nlbutts/coilgun/docs/design comparison.xlsx

Sheet: External Iron Testing
Washers | no washers | Ext Iron | Ext Iron2
10.29365509 | 10.65443507 | 10.03970386 | 10.06696618
18.79807226 | 16.36530327 | 19.62548278 | 19.64912549
20.94035492 | 18.17367863 | 22.6647233 | 22.24324136
21.30288856 | 19.68596519 | 22.79737086 | 22.96717005
20.60404159 | 18.18767754 | 22.31704167 | 21.54015561
18.5911185 | 15.64249792 | 19.94597873 | 19.95455111
13.24380927 | 10.58423559 | 13.75355467 | 13.80529892
2.974283821 | 4.068087345 | 3.183165582 | 3.27684716
-0.009587470903 | 0.1103616773 | -0.009284851918 | 0.0770191515
-3.322157302 | -4.074785655 | -3.498473798 | -3.319402114
-13.10925339 | -10.64019175 | -13.71870311 | -13.69363987
-19.11650201 | -15.50716352 | -20.10438396 | -20.06682295
-21.50865006 | -18.81385419 | -22.66648083 | -22.43215708
-21.41387312 | -19.59806682 | -22.78030393 | -22.9287232
-21.55803519 | -18.06346832 | -22.70415914 | -22.41953264
-18.96112394 | -15.40116795 | -19.87568403 | -19.76907168
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
