nlbutts/coilgun/spice/Isolated Voltage Measurement.asc

D1: diode
R1: res; 1e6
R3: res; 1e6
V1: voltage; 450
Named nets: 0
.tran 1
