nlbutts/coilgun/docs/VelocityMeasurements.xlsx

Item | Value | Units
Distance | 6 | Feet
Time | 0.065 | Seconds
Speed of sound in air | 1125 | ft/sec
Time Correction | 0.005333333333
Actual Travel Time | 0.05966666667
Velocity | 100.5586592 | ft/sec
