nlbutts/coilgun/(commit log)

2017-07-12 Moved from Hg to git.
    [Opto-isolator.xlsx, VelocityMeasurements.xlsx, design comparison.xlsx]
2017-07-24 Updates to FEMM and Tina sim. Added the start of the next circuit.
    [charger.kicad_pcb, charger.sch]
2017-07-25 Started work on the schematic. Added some more simulations.
    [Boost.sch, CapSwitch.sch, DigitalOpto.sch, charger.sch]
2017-07-25 Updated schematic.
    [Boost.sch, CapSwitch.sch, DigitalOpto.sch]
2017-08-05 Started work on the schematic.
    [Boost.sch, CapSwitch.sch, DigitalOpto.sch]
